grnwaveworkshop/MicroDroidUpgrades/MotorLegs/Wheel.stl

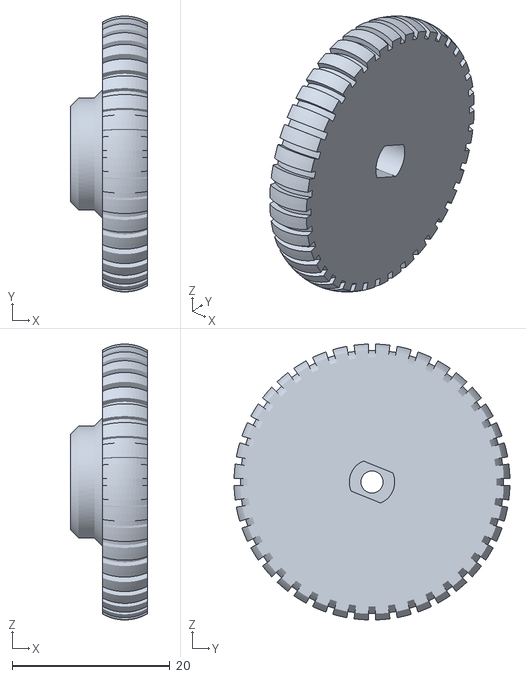
[picture p1: CAD file, 2024-09-28]
MotorLegs/Wheel.stl
9.70 x 35.0 x 35.0
