grnwaveworkshop/MicroDroidUpgrades/MotorLegs/LLEGB.stl

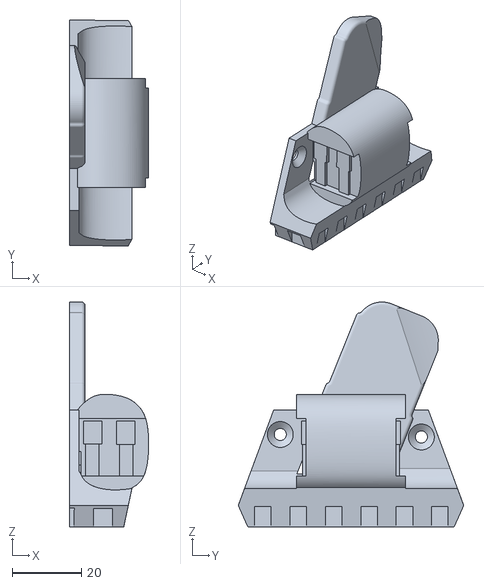
[picture p2: CAD file, 2024-09-28]
MotorLegs/LLEGB.stl
23.0 x 65.3 x 65.1
