grnwaveworkshop/MicroDroidUpgrades/MotorLegs/LLEGA.stl

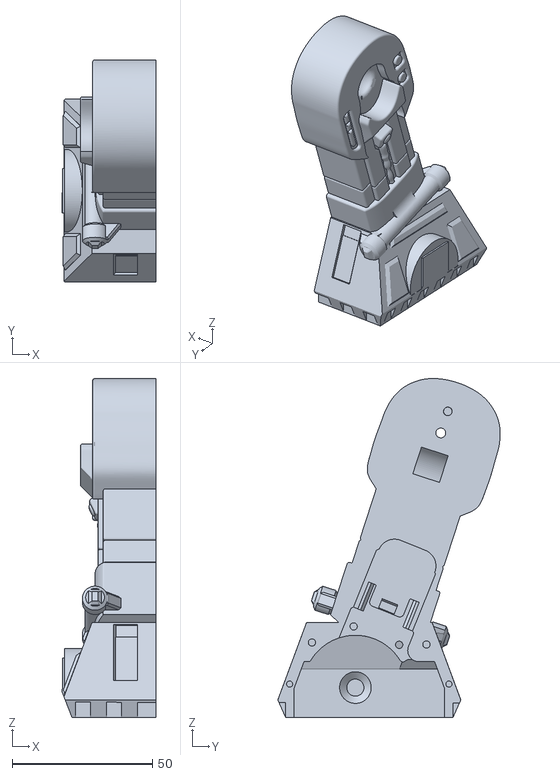
[picture p3: CAD file, 2024-09-28]
MotorLegs/LLEGA.stl
33.4 x 79.3 x 120.9
