grnwaveworkshop/MicroDroidUpgrades/MotorLegs/MotorLegs.3mf

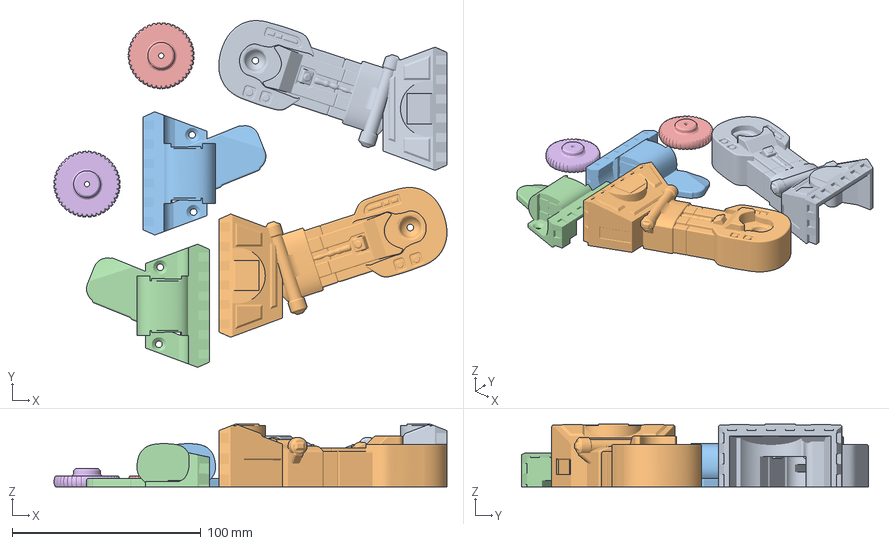
[picture p4: CAD file, 2024-09-28]
MotorLegs/MotorLegs.3mf
208.2 x 183.7 x 33.4 mm
RLEGA.stl
LLEGA.stl
RLEGB.stl
LLEGB.stl
Wheel.stl x 2
