grnwaveworkshop/MicroDroidUpgrades/(list of files, cad)

Other CAD files:
MotorLegs/RLEGB.stl
MotorLegs/RLEGA.stl
